MAWoodMain/SigCapHW/SigCap.kicad_pcb

## KiCad design SigCap.kicad_pcb (2026-11-07)

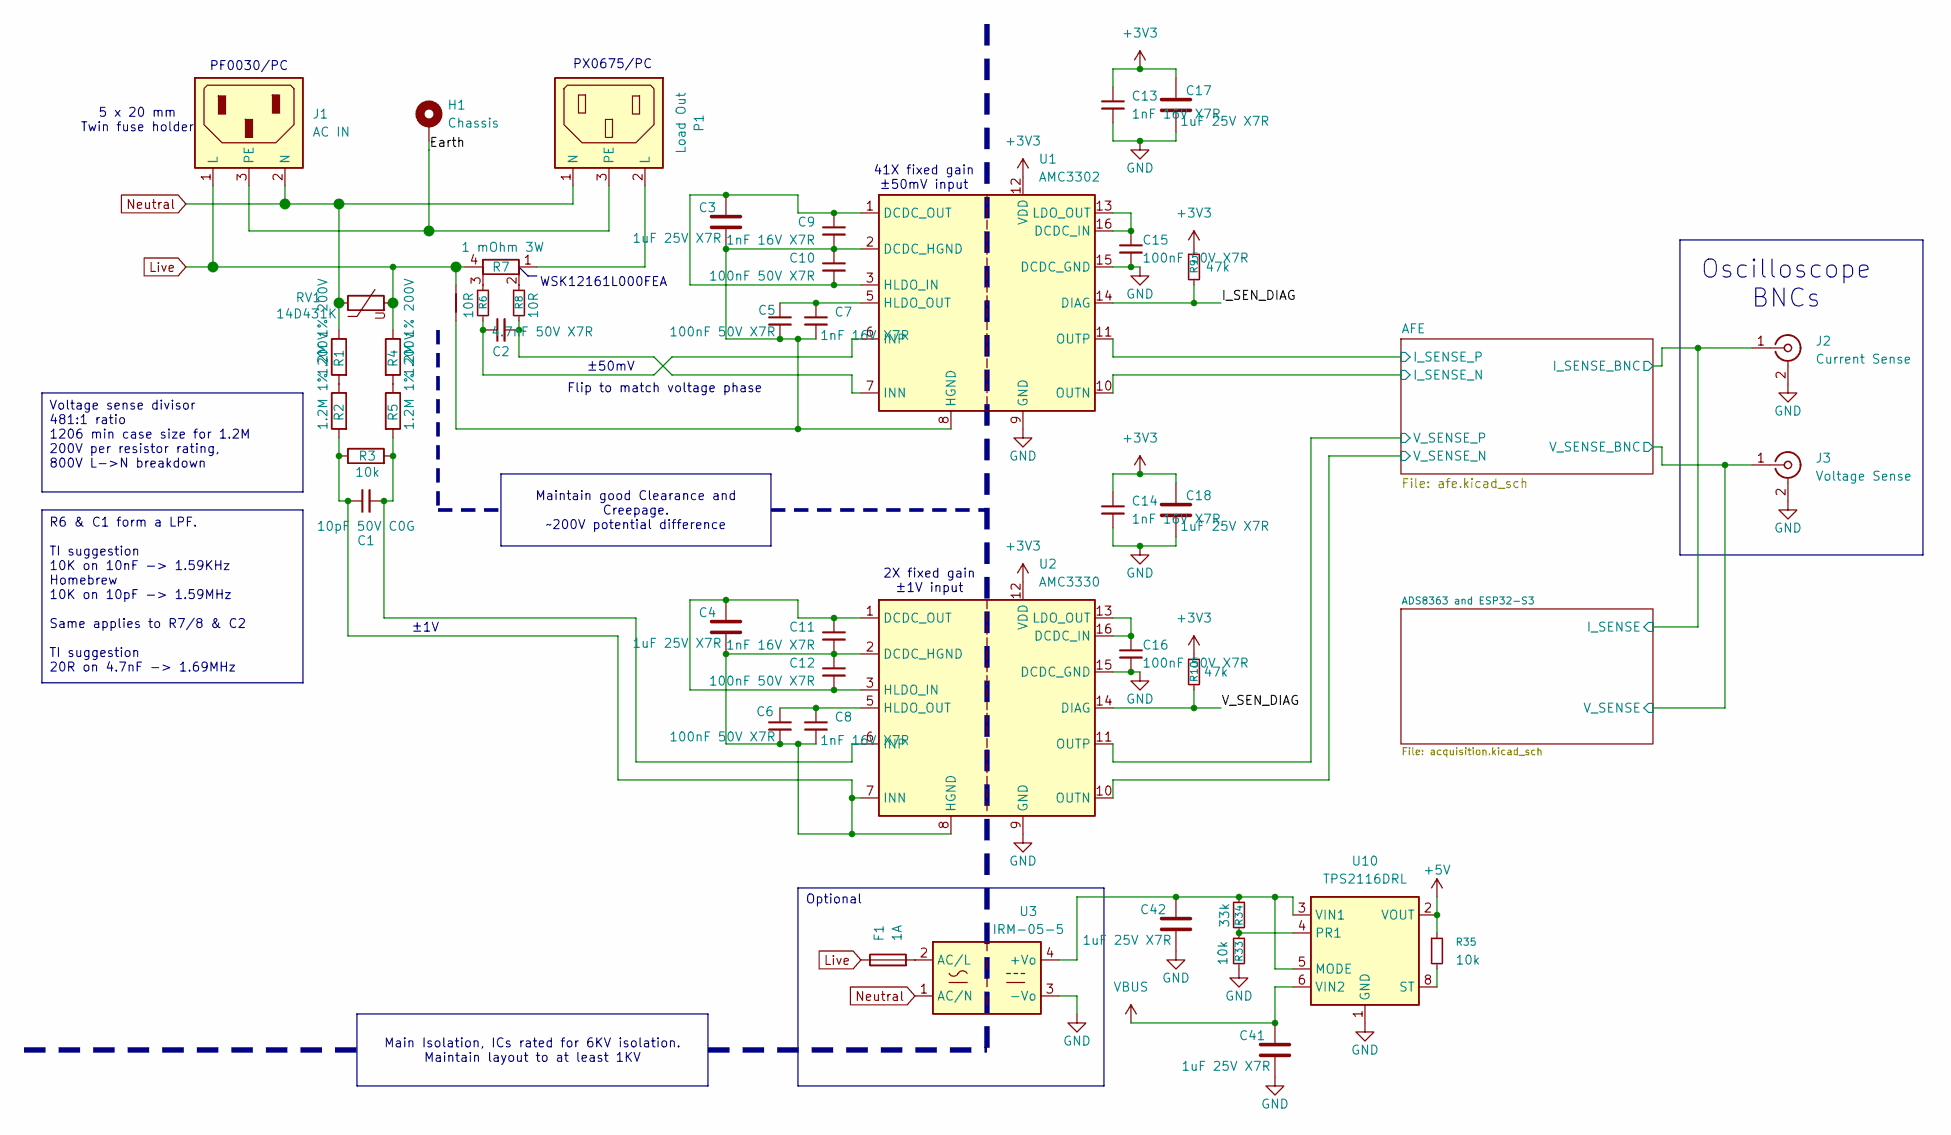
[picture p1: schematic SigCap.kicad_sch]

Parts:
C1: 10pF 50V C0G; C_0402_1005Metric; MPN GCM1555C1H100FA16D; LCSC Part # C161145
C2: 4.7nF 50V X7R; C_0402_1005Metric; MPN CL05B472KB5VPNC; LCSC Part # C307338
C3, C4, C17, C18, C41, C42: 1uF 25V X7R; C_0603_1608Metric; MPN GRM188R71E105KA12D; LCSC Part # C86020
C5, C6, C10, C12, C15, C16: 100nF 50V X7R; C_0402_1005Metric; MPN CC0402KRX7R9BB104; LCSC Part # C131394
C7, C8, C9, C11, C13, C14: 1nF 16V X7R; C_0402_1005Metric; MPN CC0402KRX7R7BB102; LCSC Part # C189467
F1: 1A; Fuse_Littelfuse_372_D8.50mm; MPN 38211000000; LCSC Part # C142712
H1: Chassis; 63849-1
J1: AC IN; PF0030PC; MPN PF0030/PC
J2: Current Sense; BNC_Amphenol_B6252HB-NPP3G-50_Horizontal; MPN B6252HB-NPP3G-50; LCSC Part # C22457552
J3: Voltage Sense; BNC_Amphenol_B6252HB-NPP3G-50_Horizontal; MPN B6252HB-NPP3G-50; LCSC Part # C22457552
NT1: L->HGND; NetTie-2_SMD_Pad0.5mm
P1: Load Out; PX0675PC; MPN PX0675/PC; LCSC Part # C3095293
R1, R2, R4, R5: 1.2M 1% 200V; R_1206_3216Metric; MPN CRCW12061M20FKEA; LCSC Part # C2085747
R3, R33, R35: 10k; R_0402_1005Metric; MPN 0402WGF1002TCE; LCSC Part # C25744
R6, R8: 10R; R_0402_1005Metric; MPN 0402WGF100JTCE; LCSC Part # C25077
R7: 1 mOhm 3W; WSK1216; MPN WSK12161L000FEA; LCSC Part # C844476
R9, R10: 47k; R_0402_1005Metric; MPN 0402WGF4702TCE; LCSC Part # C25792
R34: 33k; R_0402_1005Metric; MPN 0402WGF3302TCE; LCSC Part # C25779
RV1: 14D431K; RV_Disc_D15.5mm_W5.2mm_P7.5mm; MPN MOV-14D431K; LCSC Part # C1527438
U1: AMC3302; SOIC-16W_7.5x10.3mm_P1.27mm; MPN AMC3302DWER; LCSC Part # C4990160
U2: AMC3330; SOIC-16W_7.5x10.3mm_P1.27mm; MPN AMC3330DWER; LCSC Part # C2999368
U3: IRM-05-5; Converter_ACDC_MeanWell_IRM-05-xx_THT; MPN IRM-05-5; LCSC Part # C48603696
U10: TPS2116DRL; SOT-583-8; MPN TPS2116DRLR; LCSC Part # C3235557

Connections:
+3V3: C13.1, C14.1, C17.1, C18.1, R9.1, R10.1, U1.12 (VDD), U2.12 (VDD); also elsewhere on the board
+5V: C42.1, R34.1, U3.4 (+Vo), U10.3 (VIN1), U10.5 (MODE); also elsewhere on the board
/ADS8363 and ESP32-S3/I_SENSE: J2.1 (In); also elsewhere on the board
/ADS8363 and ESP32-S3/V_SENSE: J3.1 (In); also elsewhere on the board
/AFE/I_SENSE_N: U1.10 (OUTN); also elsewhere on the board
/AFE/I_SENSE_P: U1.11 (OUTP); also elsewhere on the board
/AFE/V_SENSE_N: U2.10 (OUTN); also elsewhere on the board
/AFE/V_SENSE_P: U2.11 (OUTP); also elsewhere on the board
/Earth: H1.1 (1_1), J1.3 (PE), P1.3 (PE)
/I_SEN_DIAG: R9.2, U1.14 (DIAG)
/V_SEN_DIAG: R10.2, U2.14 (DIAG)
GND: C13.2, C14.2, C15.2, C16.2, C17.2, C18.2, C41.2, C42.2, J2.2 (Ext), J3.2 (Ext), R33.2, U1.9 (GND), U1.15 (DCDC_GND), U2.9 (GND), U2.15 (DCDC_GND), U3.3 (-Vo), U10.1 (GND); also elsewhere on the board
Live: F1.1, J1.1 (L), NT1.2, R4.1, R7.4, RV1.2
unnamed: C41.1, U10.6 (VIN2)
unnamed: P1.2 (L), R7.1
unnamed: R1.2, R2.1
unnamed: R4.2, R5.1
unnamed: R6.1, R7.3
unnamed: R7.2, R8.1
unnamed: R33.1, R34.2, U10.4 (PR1)
unnamed: R35.1, U10.2 (VOUT), U10.7 (VOUT)
unnamed: R35.2, U10.8 (ST)
unnamed: C3.2, C5.2, C7.2, C9.2, C10.1, NT1.1, U1.2 (DCDC_HGND), U1.8 (HGND)
unnamed: C15.1, U1.13 (LDO_OUT), U1.16 (DCDC_IN)
unnamed: C3.1, C9.1, C10.2, U1.1 (DCDC_OUT), U1.3 (HLDO_IN)
unnamed: C5.1, C7.1, U1.5 (HLDO_OUT)
unnamed: C2.1, R8.2, U1.7 (INN)
unnamed: C2.2, R6.2, U1.6 (INP)
unnamed: C1.1, C4.2, C6.2, C8.2, C11.2, C12.1, R2.2, R3.1, U2.2 (DCDC_HGND), U2.7 (INN), U2.8 (HGND)
unnamed: C16.1, U2.13 (LDO_OUT), U2.16 (DCDC_IN)
unnamed: C4.1, C11.1, C12.2, U2.1 (DCDC_OUT), U2.3 (HLDO_IN)
unnamed: C6.1, C8.1, U2.5 (HLDO_OUT)
unnamed: C1.2, R3.2, R5.2, U2.6 (INP)
unnamed: F1.2, U3.2 (AC/L)
Neutral: J1.2 (N), P1.1 (N), R1.1, RV1.1, U3.1 (AC/N)

Notes on the sheet:
PF0030/PC
PX0675/PC
±50mV
41X fixed gain ±50mV input
Oscilloscope BNCs
Optional
WSK12161L000FEA
±1V
Flip to match voltage phase
5 x 20 mm Twin fuse holder
2X fixed gain ±1V input
Voltage sense divisor 481:1 ratio 1206 min case size for 1.2M 200V per resistor rating, 800V L->N breakdown
Maintain good Clearance and Creepage. ~200V potential difference
Main Isolation, ICs rated for 6KV isolation. Maintain layout to at least 1KV
R6 & C1 form a LPF. TI suggestion 10K on 10nF -> 1.59KHz Homebrew 10K on 10pF -> 1.59MHz Same applies to R7/8 & C2 TI suggestion 20R on 4.7nF -> 1.69MHz

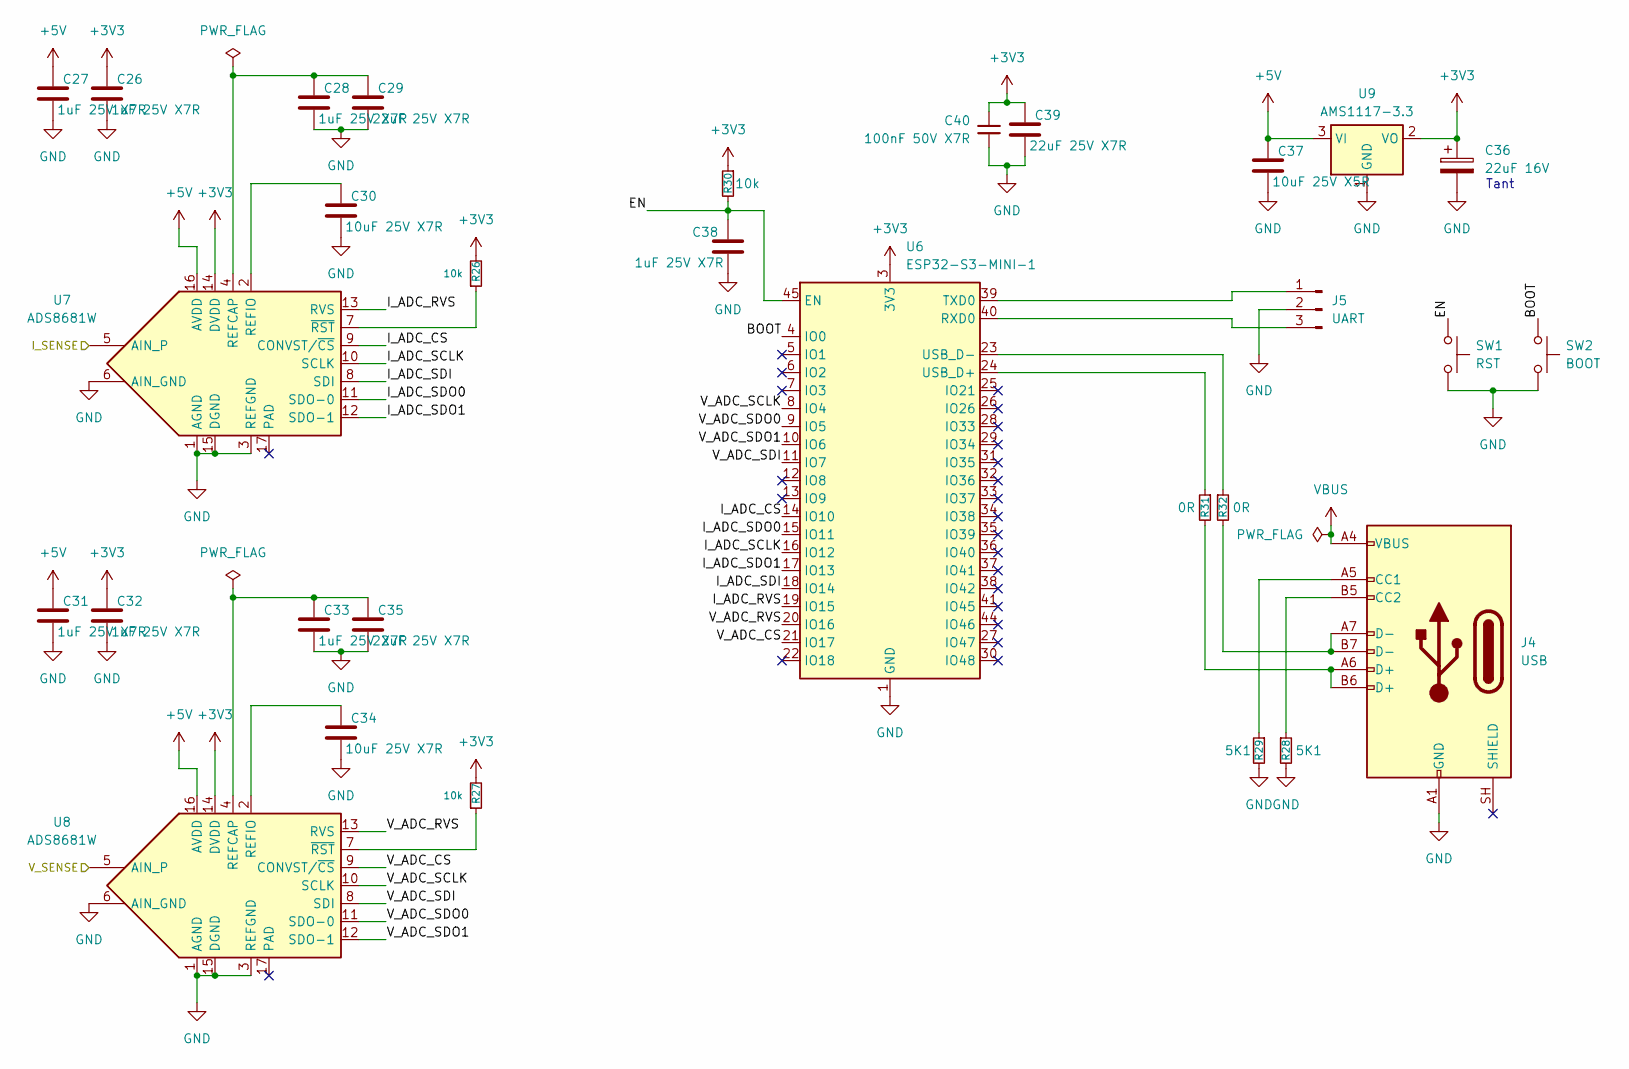
[picture p2: schematic acquisition.kicad_sch]

Parts:
C26, C27, C28, C31, C32, C33, C38: 1uF 25V X7R; C_0603_1608Metric; MPN GRM188R71E105KA12D; LCSC Part # C86020
C29, C35, C39: 22uF 25V X7R; C_1210_3225Metric; MPN GRM32ER71E226KE15L; LCSC Part # C21397
C30, C34: 10uF 25V X7R; C_1206_3216Metric; MPN GRM31CR71E106KA12L; LCSC Part # C77093
C36: 22uF 16V; CP_EIA-3528-21_Kemet-B; MPN TPSB226K016R0600; LCSC Part # C1952809
C37: 10uF 25V X5R; C_1206_3216Metric; MPN CL31A106KAHNNNE; LCSC Part # C9807
C40: 100nF 50V X7R; C_0402_1005Metric; MPN CC0402KRX7R9BB104; LCSC Part # C131394
J4: USB; USB_C_Receptacle_GCT_USB4105-xx-A_16P_TopMnt_Horizontal; MPN USB4105-GF-A; LCSC Part # C3020560
J5: UART; PinHeader_1x03_P2.54mm_Vertical; MPN TSW-103-07-G-S; LCSC Part # C3335811
R26, R27, R30: 10k; R_0402_1005Metric; MPN 0402WGF1002TCE; LCSC Part # C25744
R28, R29: 5K1; R_0402_1005Metric; MPN 0402WGF5101TCE; LCSC Part # C25905
R31, R32: 0R; R_0402_1005Metric; MPN AC0402JR-070RL; LCSC Part # C138289
SW1: RST; SW_Tactile_SKHH_Angled; MPN SKHHLQA010; LCSC Part # C125034
SW2: BOOT; SW_Tactile_SKHH_Angled; MPN SKHHLQA010; LCSC Part # C125034
U6: ESP32-S3-MINI-1; ESP32-S2-MINI-1; MPN ESP32-S3-MINI-1-N4R2; LCSC Part # C3013941
U7, U8: ADS8681W; QFN-16-1EP_4x4mm_P0.65mm_EP2.7x2.7mm; MPN ADS8681WRUMT; LCSC Part # C41410098
U9: AMS1117-3.3; SOT-223-3_TabPin2; MPN AMS1117-3.3; LCSC Part # C6186

Connections:
+3V3: C26.1, C32.1, C36.1, C39.1, C40.1, R26.2, R27.2, R30.1, U6.3 (3V3), U7.14 (DVDD), U8.14 (DVDD), U9.2 (VO); also elsewhere on the board
+5V: C27.1, C31.1, C37.1, U7.16 (AVDD), U8.16 (AVDD), U9.3 (VI); also elsewhere on the board
/ADS8363 and ESP32-S3/BOOT: SW2.1, U6.4 (IO0)
/ADS8363 and ESP32-S3/EN: C38.1, R30.2, SW1.1, U6.45 (EN)
/ADS8363 and ESP32-S3/I_ADC_CS: U6.14 (IO10), U7.9 (CONVST/~CS)
/ADS8363 and ESP32-S3/I_ADC_RVS: U6.19 (IO15), U7.13 (RVS)
/ADS8363 and ESP32-S3/I_ADC_SCLK: U6.16 (IO12), U7.10 (SCLK)
/ADS8363 and ESP32-S3/I_ADC_SDI: U6.18 (IO14), U7.8 (SDI)
/ADS8363 and ESP32-S3/I_ADC_SDO0: U6.15 (IO11), U7.11 (SDO-0)
/ADS8363 and ESP32-S3/I_ADC_SDO1: U6.17 (IO13), U7.12 (SDO-1)
/ADS8363 and ESP32-S3/I_SENSE: U7.5 (AIN_P); also elsewhere on the board
/ADS8363 and ESP32-S3/V_ADC_CS: U6.21 (IO17), U8.9 (CONVST/~CS)
/ADS8363 and ESP32-S3/V_ADC_RVS: U6.20 (IO16), U8.13 (RVS)
/ADS8363 and ESP32-S3/V_ADC_SCLK: U6.8 (IO4), U8.10 (SCLK)
/ADS8363 and ESP32-S3/V_ADC_SDI: U6.11 (IO7), U8.8 (SDI)
/ADS8363 and ESP32-S3/V_ADC_SDO0: U6.9 (IO5), U8.11 (SDO-0)
/ADS8363 and ESP32-S3/V_ADC_SDO1: U6.10 (IO6), U8.12 (SDO-1)
/ADS8363 and ESP32-S3/V_SENSE: U8.5 (AIN_P); also elsewhere on the board
GND: C26.2, C27.2, C28.2, C29.2, C30.2, C31.2, C32.2, C33.2, C34.2, C35.2, C36.2, C37.2, C38.2, C39.2, C40.2, J4.A1 (GND), J4.A12 (GND), J4.B1 (GND), J4.B12 (GND), J5.2, R28.2, R29.2, SW1.2, SW2.2, U6.1 (GND), U6.2 (GND), U6.42 (GND), U6.43 (GND), U6.46 (GND), U6.47 (GND), U6.48 (GND), U6.49 (GND), U6.50 (GND), U6.51 (GND), U6.52 (GND), U6.53 (GND), U6.54 (GND), U6.55 (GND), U6.56 (GND), U6.57 (GND), U6.58 (GND), U6.59 (GND), U6.60 (GND), U6.61 (GND), U6.62 (GND), U6.63 (GND), U6.64 (GND), U6.65 (GND), U7.1 (AGND), U7.3 (REFGND), U7.6 (AIN_GND), U7.15 (DGND), U8.1 (AGND), U8.3 (REFGND), U8.6 (AIN_GND), U8.15 (DGND), U9.1 (GND); also elsewhere on the board
unnamed: J4.A5 (CC1), R29.1
unnamed: J4.B5 (CC2), R28.1
unnamed: J4.A6 (D+), J4.B6 (D+), R31.2
unnamed: J4.A7 (D-), J4.B7 (D-), R32.2
unnamed: J5.1, U6.39 (TXD0)
unnamed: J5.3, U6.40 (RXD0)
unnamed 38: J4.A4 (VBUS), J4.A9 (VBUS), J4.B4 (VBUS), J4.B9 (VBUS); also elsewhere on the board
unnamed: R31.1, U6.24 (USB_D+)
unnamed: R32.1, U6.23 (USB_D-)
unnamed: C28.1, C29.1, U7.4 (REFCAP)
unnamed: C30.1, U7.2 (REFIO)
unnamed: R26.1, U7.7 (~RST)
unnamed: C33.1, C35.1, U8.4 (REFCAP)
unnamed: C34.1, U8.2 (REFIO)
unnamed: R27.1, U8.7 (~RST)

Notes on the sheet:
Tant

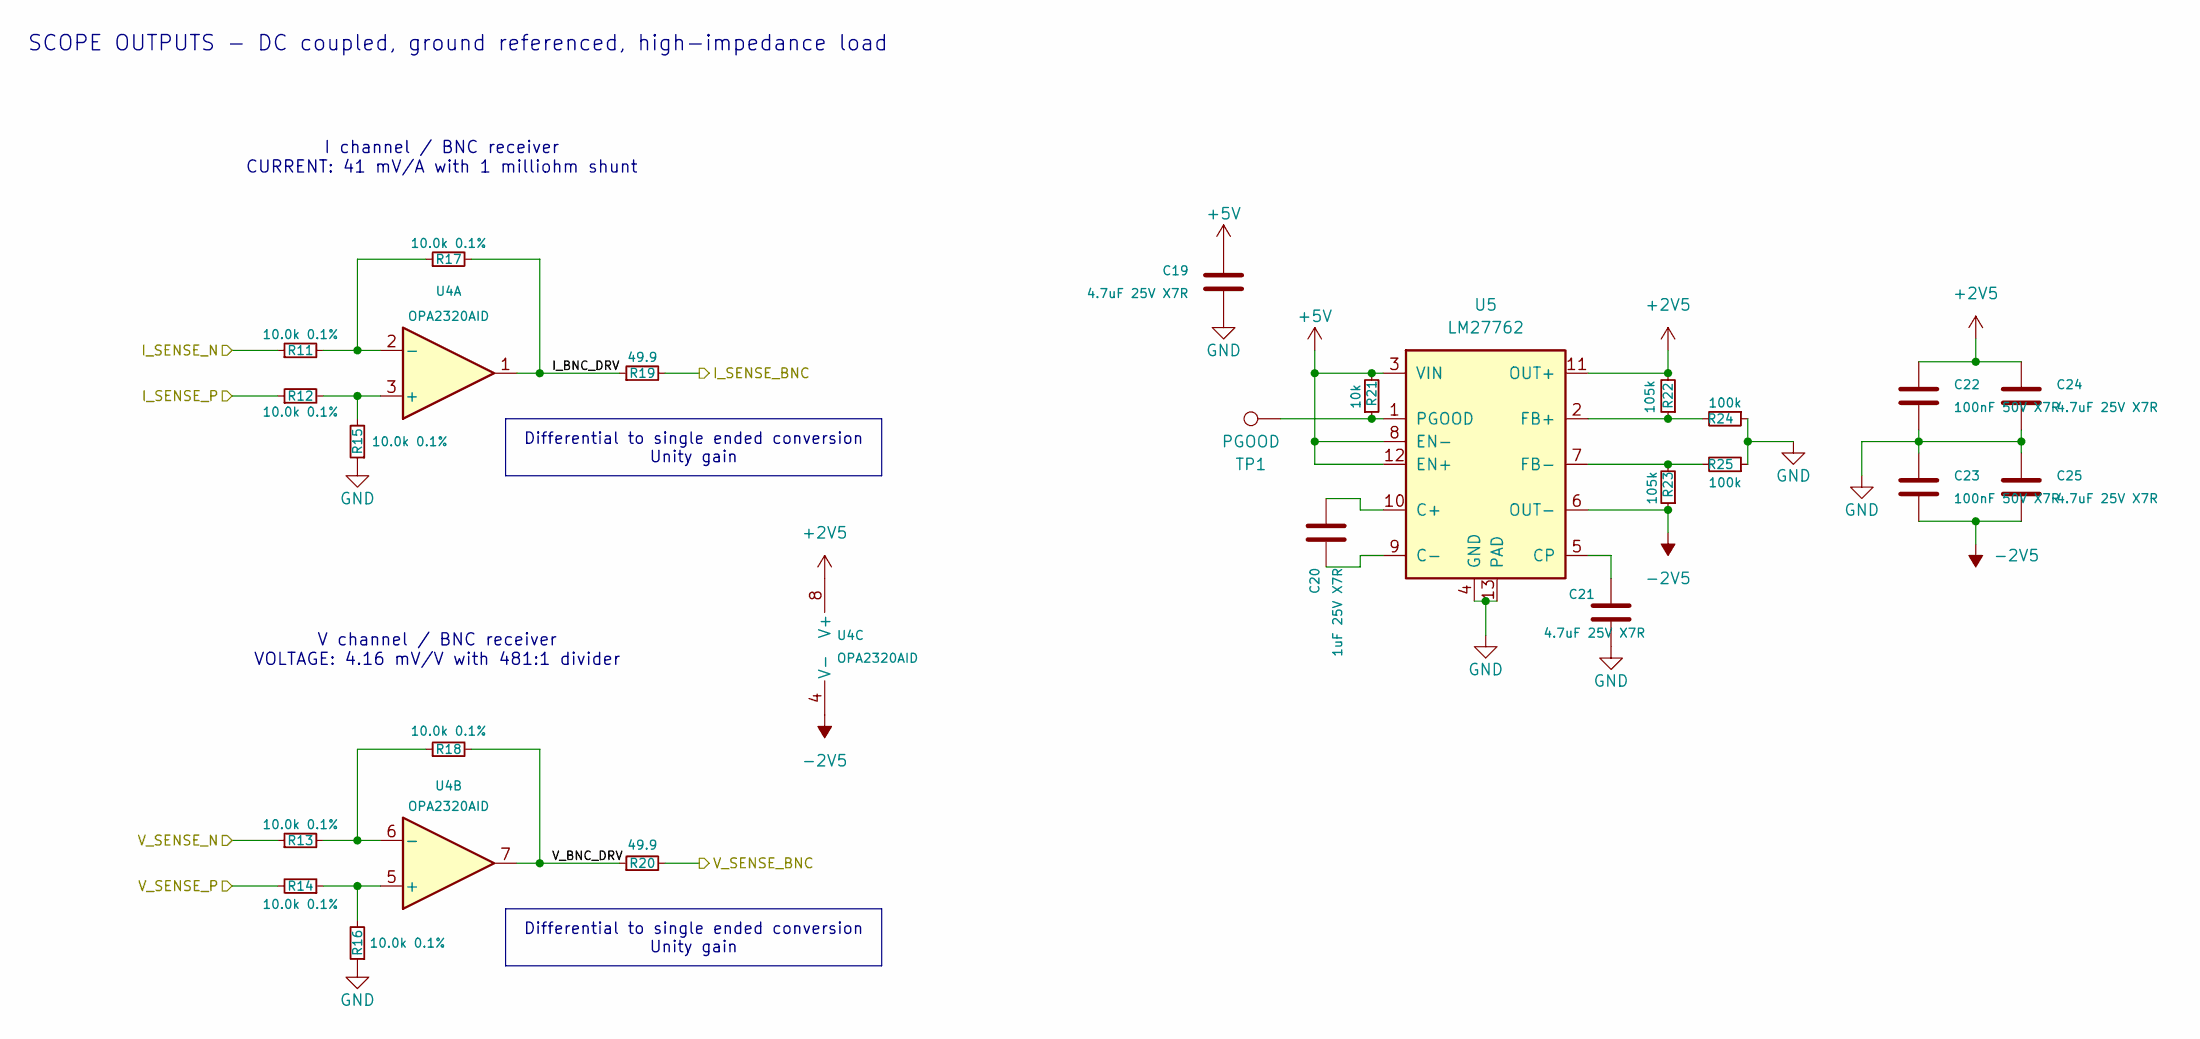
[picture p3: schematic afe.kicad_sch, SigCap AFE - Bipolar BNC outputs / direct ADS8363 inputs]

Parts:
C19, C21, C24, C25: 4.7uF 25V X7R; C_1206_3216Metric; MPN CL31B475KAHNNNE; LCSC Part # C1872
C20: 1uF 25V X7R; C_0603_1608Metric; MPN GRM188R71E105KA12D; LCSC Part # C86020
C22, C23: 100nF 50V X7R; C_0402_1005Metric; MPN CC0402KRX7R9BB104; LCSC Part # C131394
R11, R12, R13, R14, R15, R16, R17, R18: 10.0k 0.1%; R_0402_1005Metric; MPN RT0402BRD0710KL; LCSC Part # C190095
R19, R20: 49.9; R_0402_1005Metric; MPN 0402WGF499JTCE; LCSC Part # C25120
R21: 10k; R_0402_1005Metric; MPN 0402WGF1002TCE; LCSC Part # C25744
R22, R23: 105k; R_0402_1005Metric; MPN 0402WGF1053TCE; LCSC Part # C25742
R24, R25: 100k; R_0402_1005Metric; MPN 0402WGF1003TCE; LCSC Part # C25741
TP1: PGOOD; TestPoint_Keystone_5000-5004_Miniature; MPN 5000; LCSC Part # C5199900
U4: OPA2320AID; SOIC-8_3.9x4.9mm_P1.27mm; MPN OPA2320AIDR; LCSC Part # C2863402
U5: LM27762; WSON-12-1EP_3x2mm_P0.5mm_EP1x2.65_ThermalVias; MPN LM27762DSSR; LCSC Part # C473398

Connections:
+2V5: C22.2, C24.2, R22.2, U4.8 (V+), U5.11 (OUT+)
+5V: C19.2, R21.2, U5.3 (VIN), U5.8 (EN-), U5.12 (EN+); also elsewhere on the board
-2V5: C23.2, C25.1, R23.1, U4.4 (V-), U5.6 (OUT-)
/ADS8363 and ESP32-S3/I_SENSE: R19.2; also elsewhere on the board
/ADS8363 and ESP32-S3/V_SENSE: R20.2; also elsewhere on the board
/AFE/I_BNC_DRV: R17.2, R19.1, U4.1
/AFE/I_SENSE_N: R11.1; also elsewhere on the board
/AFE/I_SENSE_P: R12.1; also elsewhere on the board
/AFE/V_BNC_DRV: R18.2, R20.1, U4.7
/AFE/V_SENSE_N: R13.1; also elsewhere on the board
/AFE/V_SENSE_P: R14.2; also elsewhere on the board
GND: C19.1, C21.1, C22.1, C23.1, C24.1, C25.2, R15.1, R16.1, R24.1, R25.1, U5.4 (GND), U5.13 (PAD); also elsewhere on the board
unnamed: R12.2, R15.2, U4.3 (+)
unnamed: R11.2, R17.1, U4.2 (-)
unnamed: R14.1, R16.2, U4.5 (+)
unnamed: R13.2, R18.1, U4.6 (-)
unnamed: C20.1, U5.10 (C+)
unnamed: C20.2, U5.9 (C-)
unnamed: C21.2, U5.5 (CP)
unnamed: R22.1, R24.2, U5.2 (FB+)
unnamed: R23.2, R25.2, U5.7 (FB-)
unnamed: R21.1, TP1.1 (1_1), U5.1 (PGOOD)

Notes on the sheet:
I channel / BNC receiver CURRENT: 41 mV/A with 1 milliohm shunt
V channel / BNC receiver VOLTAGE: 4.16 mV/V with 481:1 divider
SCOPE OUTPUTS - DC coupled, ground referenced, high-impedance load
Differential to single ended conversion Unity gain

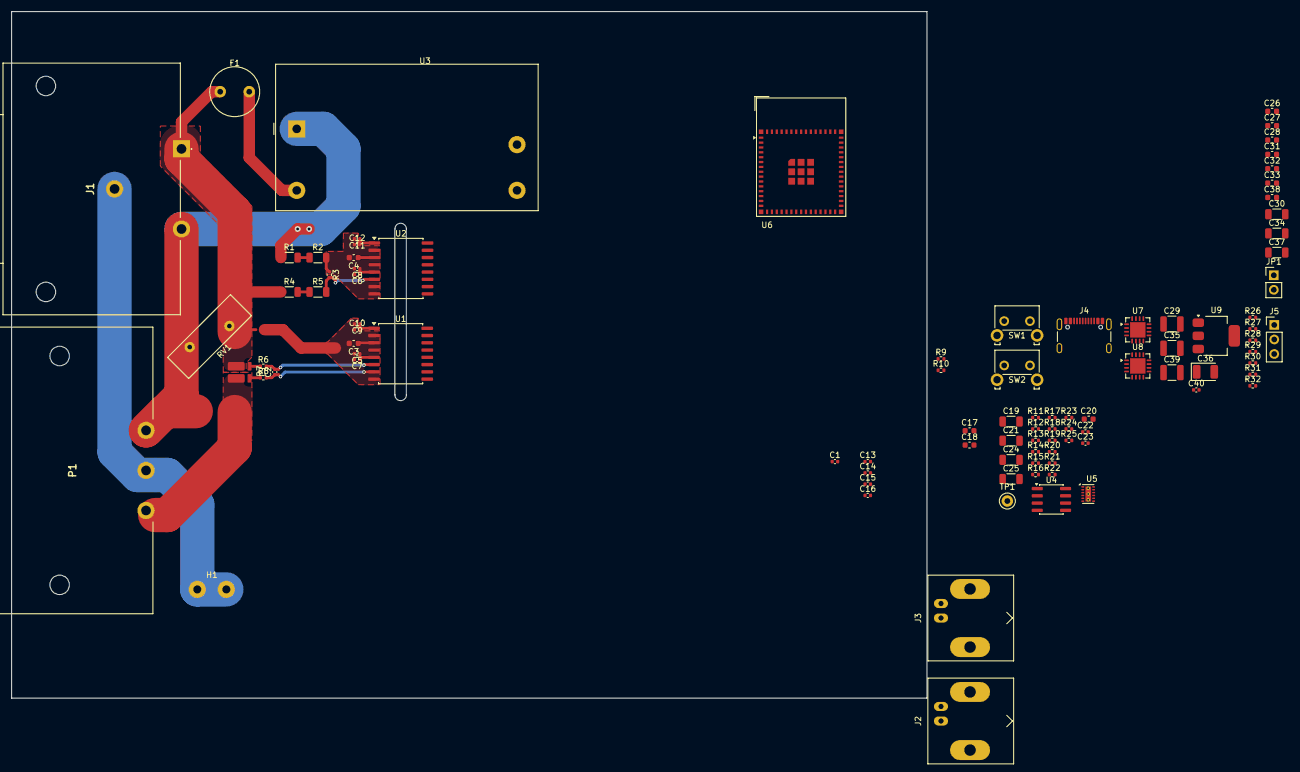
[picture p4: board SigCap.kicad_pcb from above]

Board: 2 copper layers, 160.0 x 120.0 mm, 95 parts (0 on the bottom side), 74 nets.

Other parts of the board:
JP1: USB Power; PinHeader_1x02_P2.54mm_Vertical

Their connections:
+5V: JP1.2 (B); also elsewhere on the board
unnamed 38: JP1.1 (A); also elsewhere on the board
