MAWoodMain/SigCapHW/(commit log)

2026-11-07 Initial schematic complete
    [SigCap.kicad_pcb, SigCap.kicad_sch, acquisition.kicad_sch, afe.kicad_sch]
2026-11-07 Ignore KiCad generated and local files
2026-11-07 Assign stocked JLC parts and standard footprints
    [BOM.csv, SigCap.kicad_sch, acquisition.kicad_sch, afe.kicad_sch]
2026-11-07 Use stocked 105 kΩ resistor for AFE positive rail
    [BOM.csv, afe.kicad_sch]
2026-11-07 Source J1 mains inlet through distributors
    [BOM.csv]
2026-11-07 Sync BOM with assigned SigCap footprints
    [BOM.csv]
2026-11-07 Check in SigCap footprint library and schematic assignments
    [SigCap.kicad_sch, acquisition.kicad_sch, afe.kicad_sch]
2026-11-07 Use right-angle Alps switches for reset and boot
    [BOM.csv, acquisition.kicad_sch]
2026-11-07 Checkpoint SigCap layout and USB power mux
    [BOM.csv, SigCap.kicad_pcb, SigCap.kicad_sch, acquisition.kicad_sch]
